ergoadams/cansat/README.md

# CanSat

Gümnaasiumi uurimistöö raames valminud CanSat-i tarkvara

## Komponendid  
* G28U7FTTL (GPS)
* GY-521 (Güroskoop/kiirendusandur)
* MPL115A2 (Temperatuuri/õhurõhuandur)
* MTX2-433-10 (Raadioside edastaja)
* OV7670 with FIFO (Kaamera) (Ei tööta/ei ole kasutuses)
* 5V -> 3.3V pingemuundur
* SD-kaardi moodul
* Arduino Nano
